EdgerEquals/plasma-ignition/sim/plots/03_fullchain_node_and_SRiso_delay.png

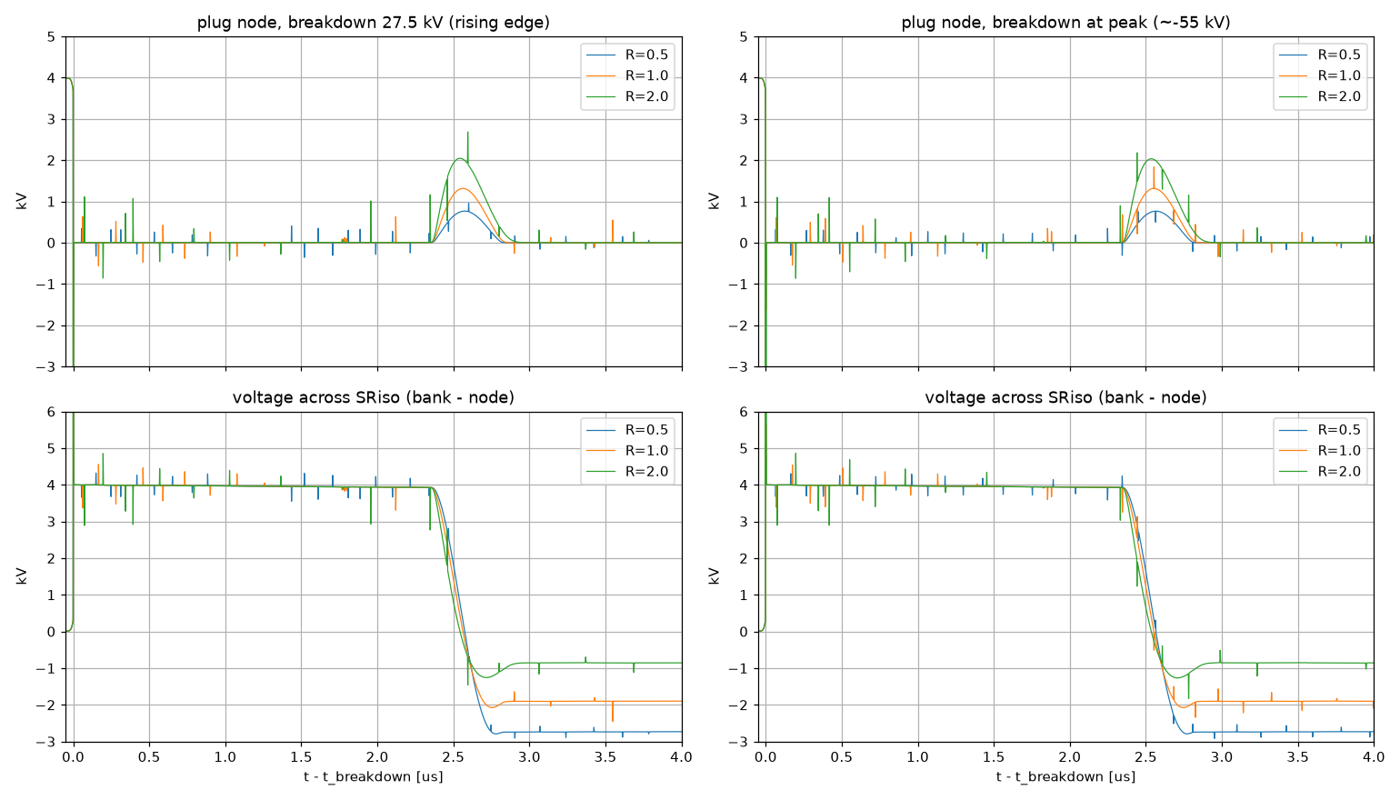
sim/plots/03_fullchain_node_and_SRiso_delay.png
