EdgerEquals/plasma-ignition/sim/plots/04_fullchain_stage2_current_bank.png

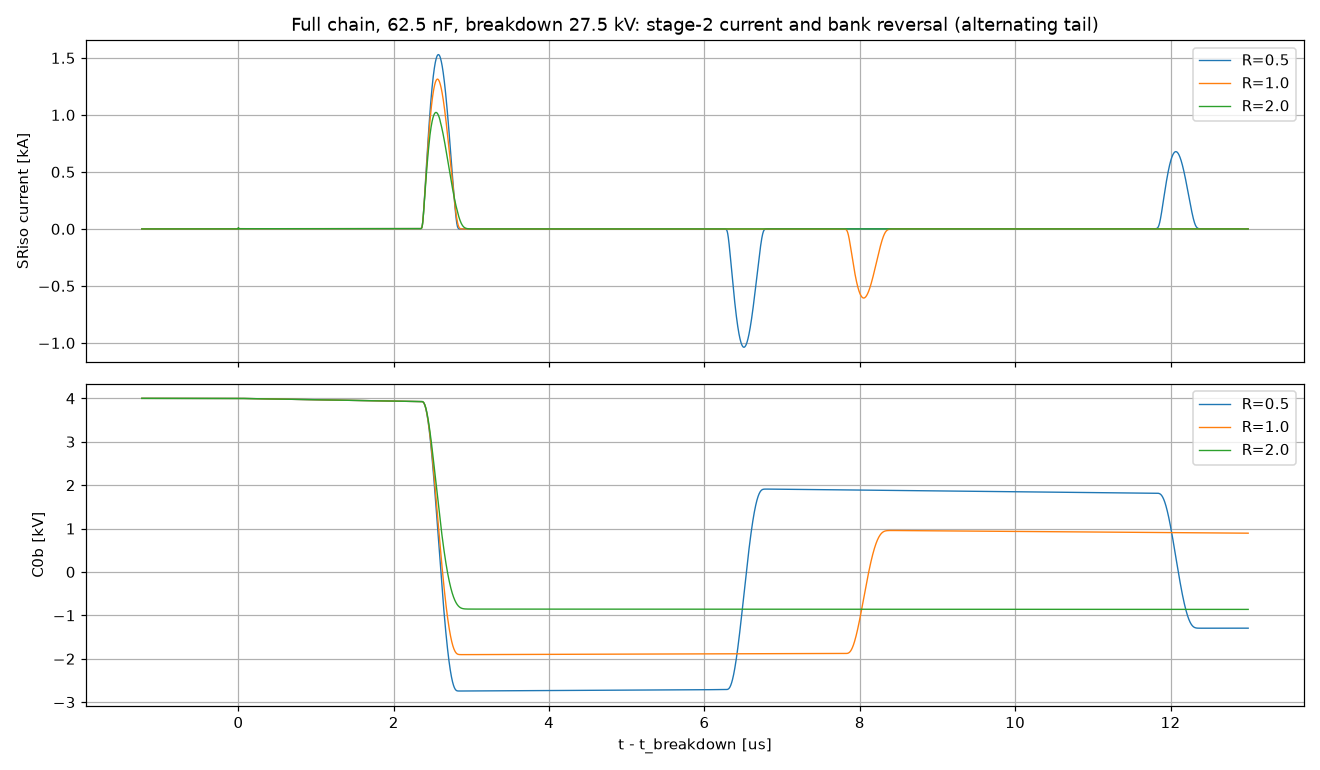
sim/plots/04_fullchain_stage2_current_bank.png
