EdgerEquals/plasma-ignition/sim/plots/05_quench_cases.png

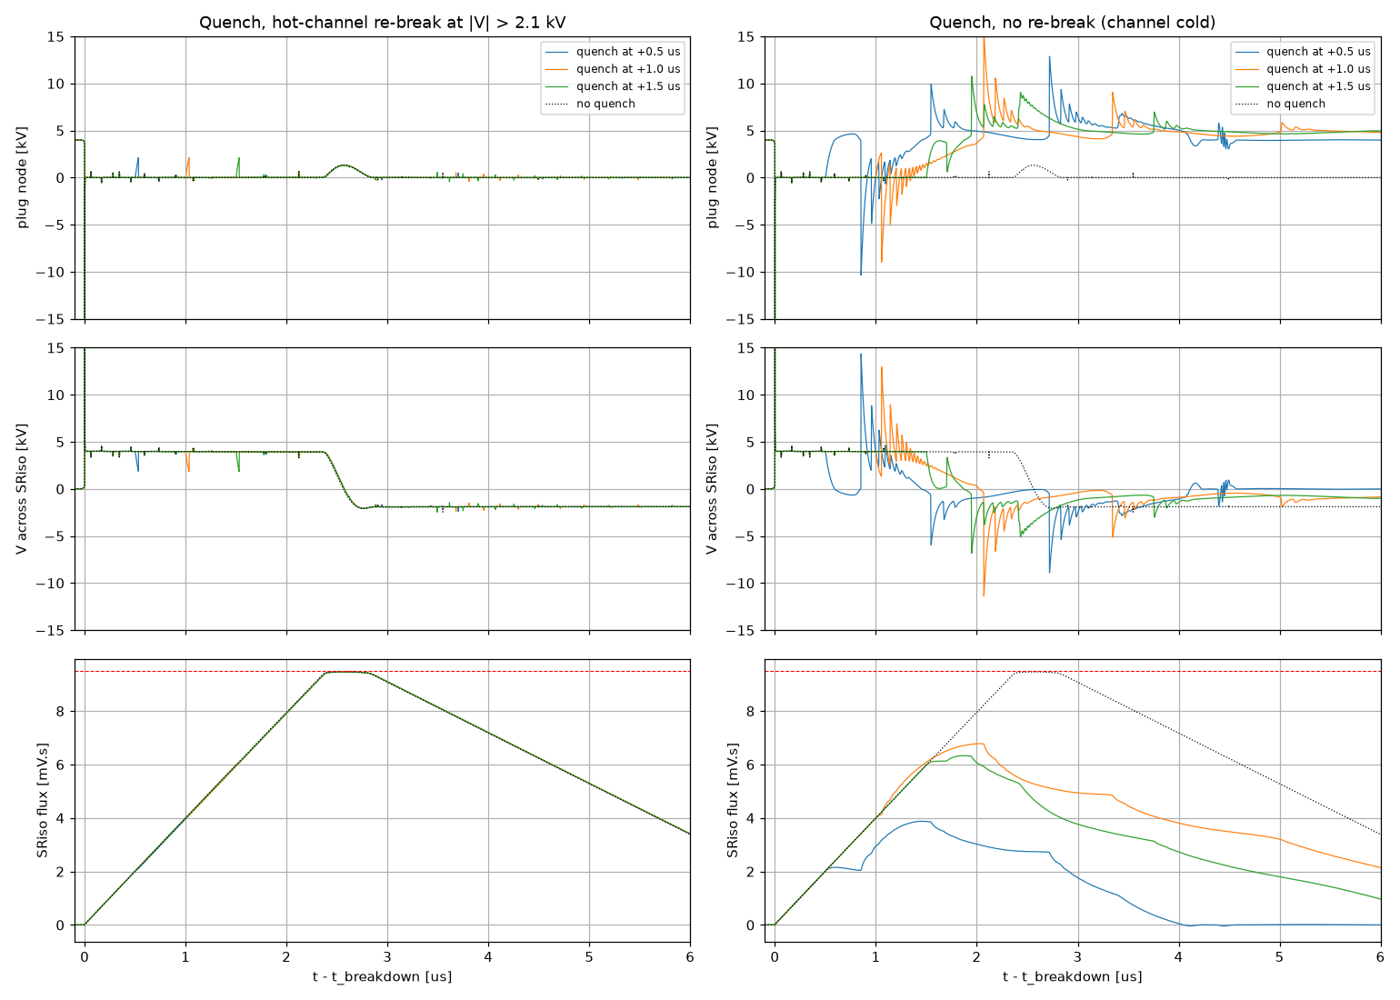
sim/plots/05_quench_cases.png
