EdgerEquals/plasma-ignition/sim/plots/06_core_model_comparison.png

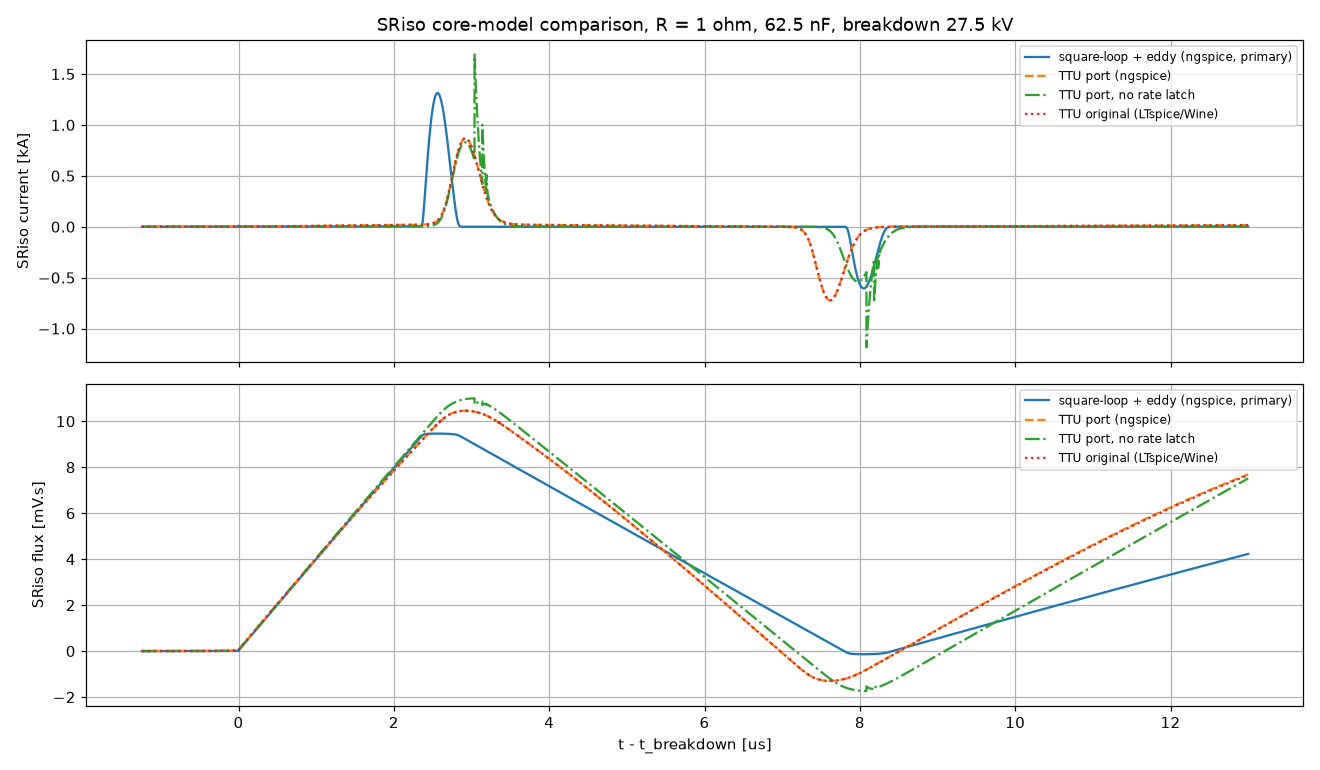
sim/plots/06_core_model_comparison.png
