EdgerEquals/plasma-ignition/sim/plots/07_summary_delivery_delay.png

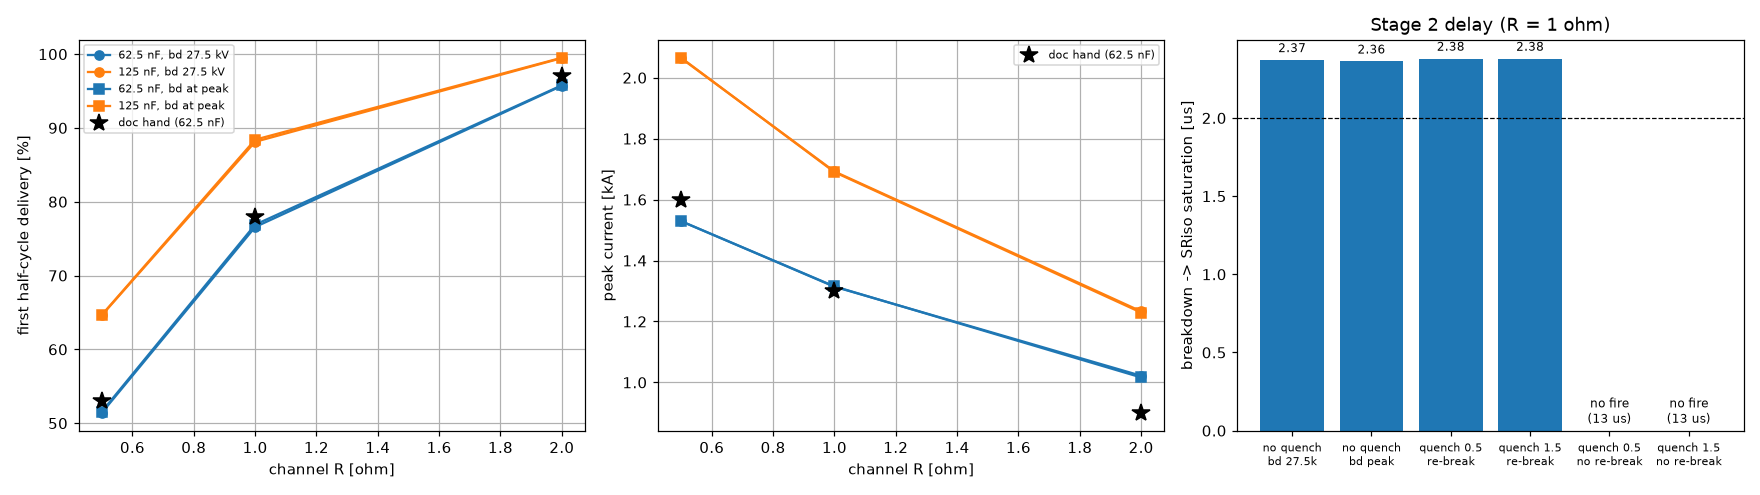
sim/plots/07_summary_delivery_delay.png
