EdgerEquals/plasma-ignition/sim/plots/08_jitter_and_flux_swing.png

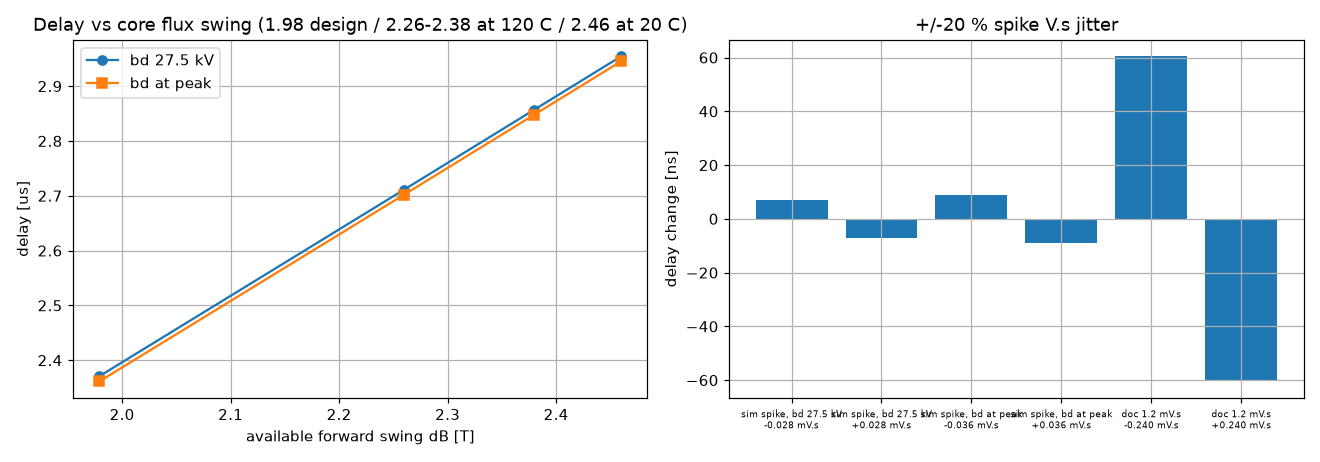
sim/plots/08_jitter_and_flux_swing.png
