EdgerEquals/plasma-ignition/sim/plots/09_quench_mitigations.png

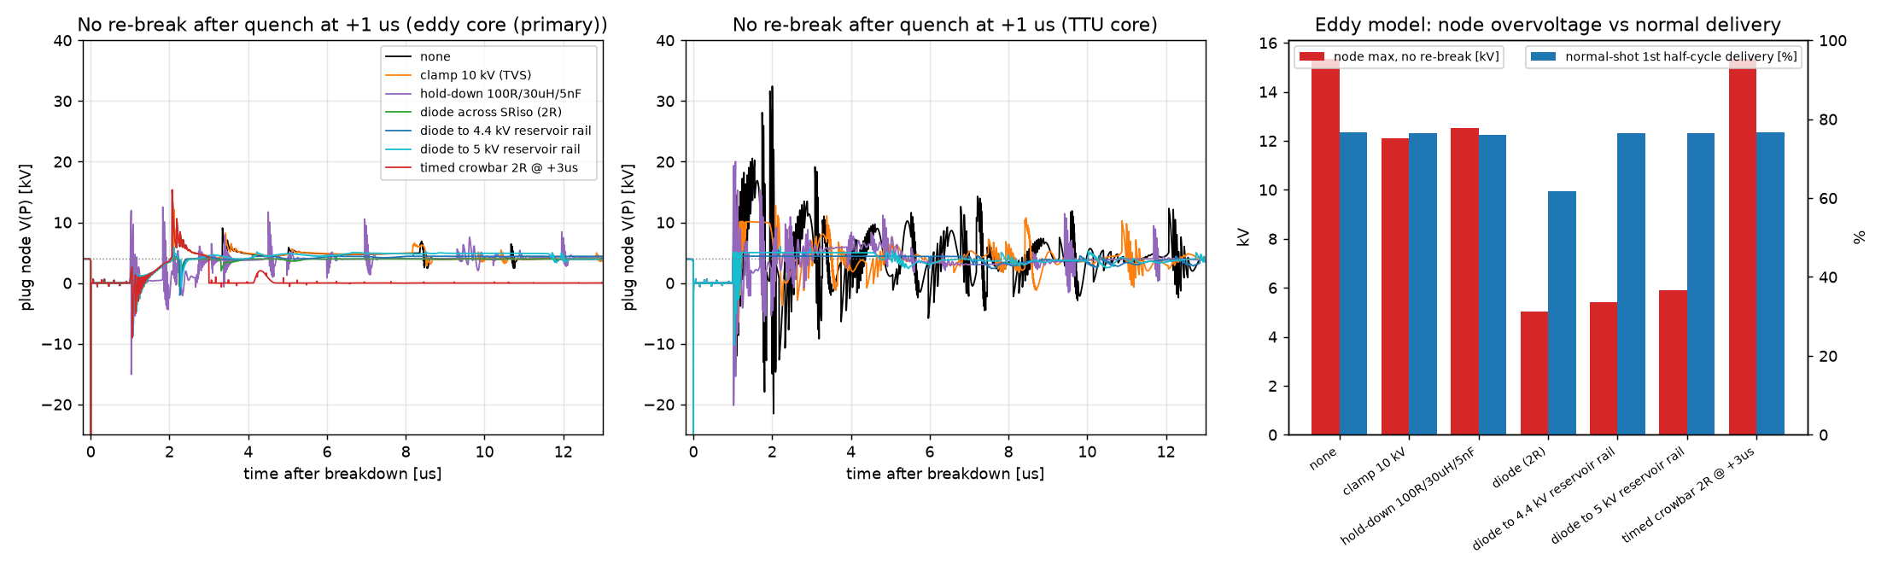
sim/plots/09_quench_mitigations.png
