EdgerEquals/plasma-ignition/sim/plots/10_sr3_ferrite.png

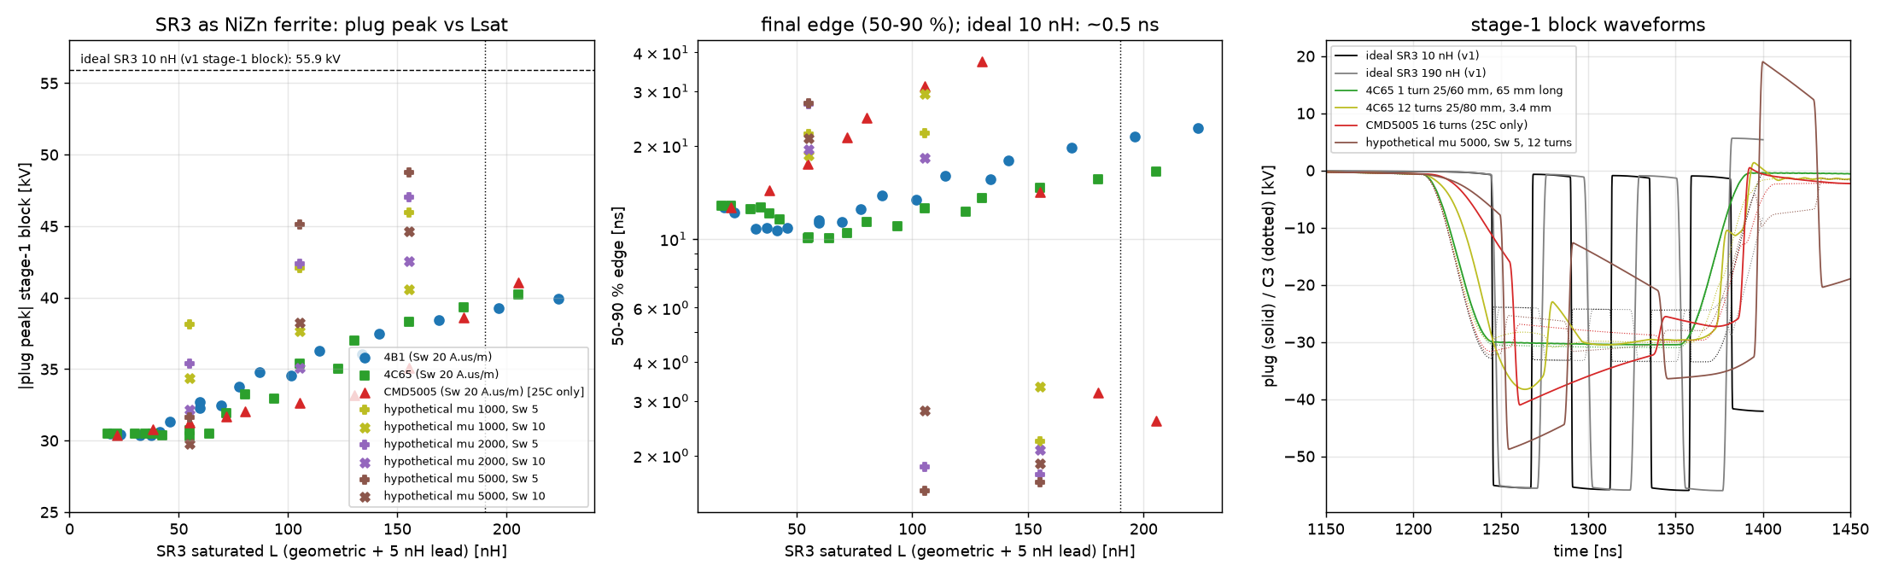
sim/plots/10_sr3_ferrite.png
