EdgerEquals/plasma-ignition/sim/plots/11_cblock_multishot.png

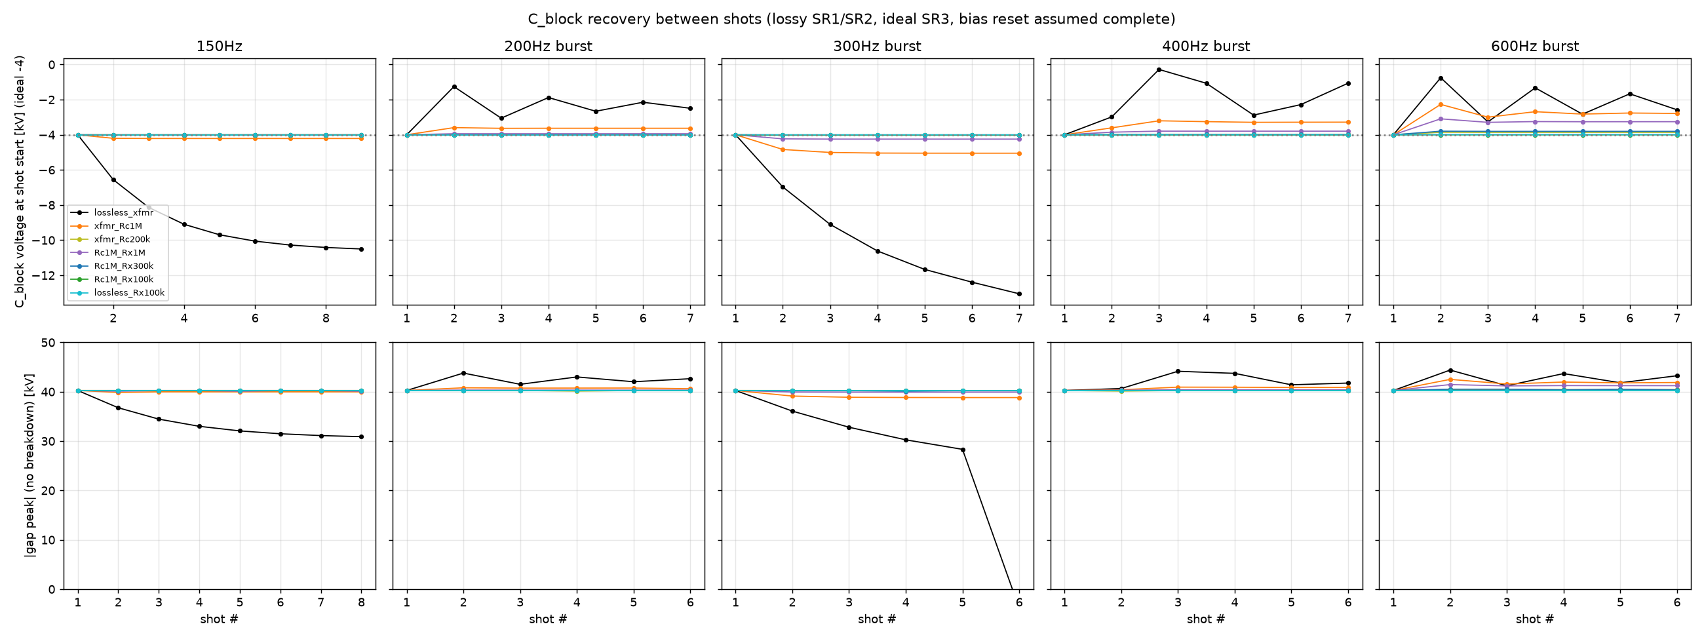
sim/plots/11_cblock_multishot.png
