EdgerEquals/plasma-ignition/sim/plots/12_cblock_recovery_waveforms.png

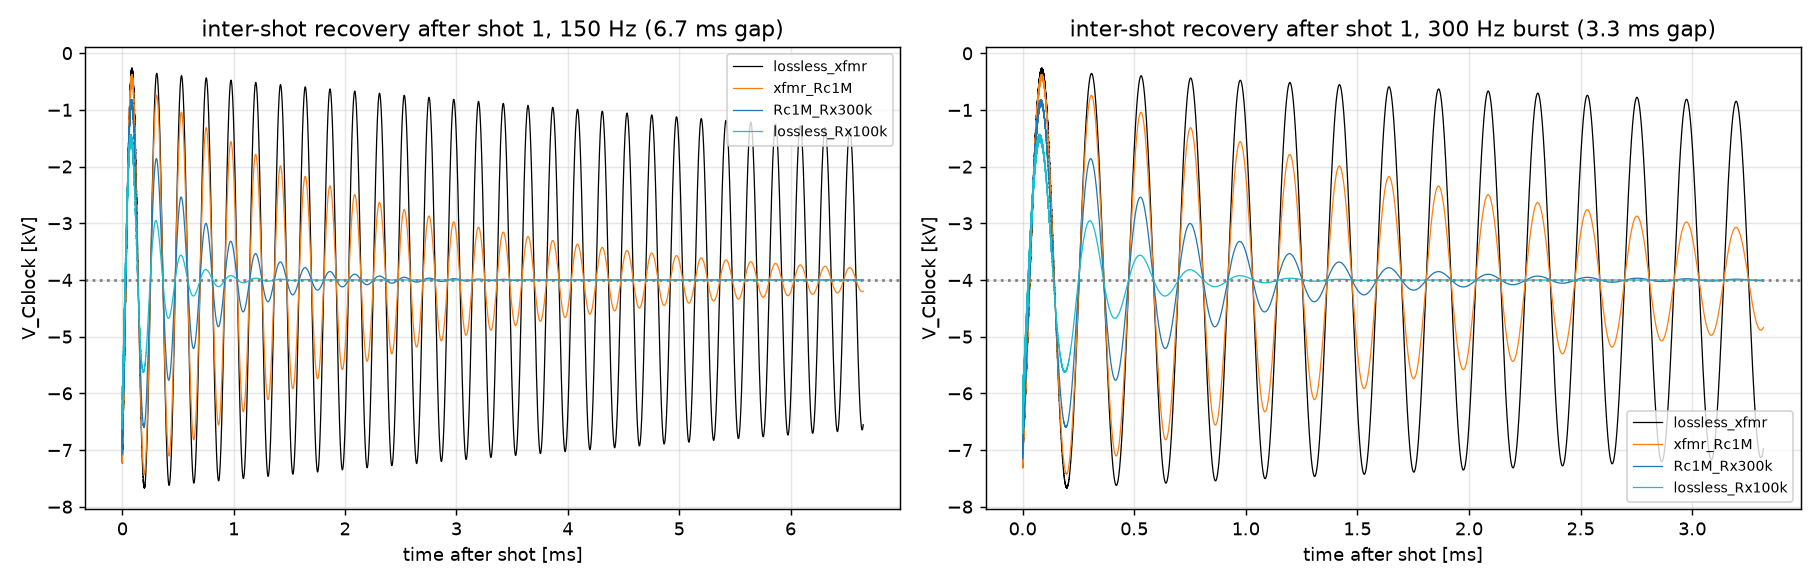
sim/plots/12_cblock_recovery_waveforms.png
