EdgerEquals/plasma-ignition/sim/plots/revc/revc_restrike_node.png

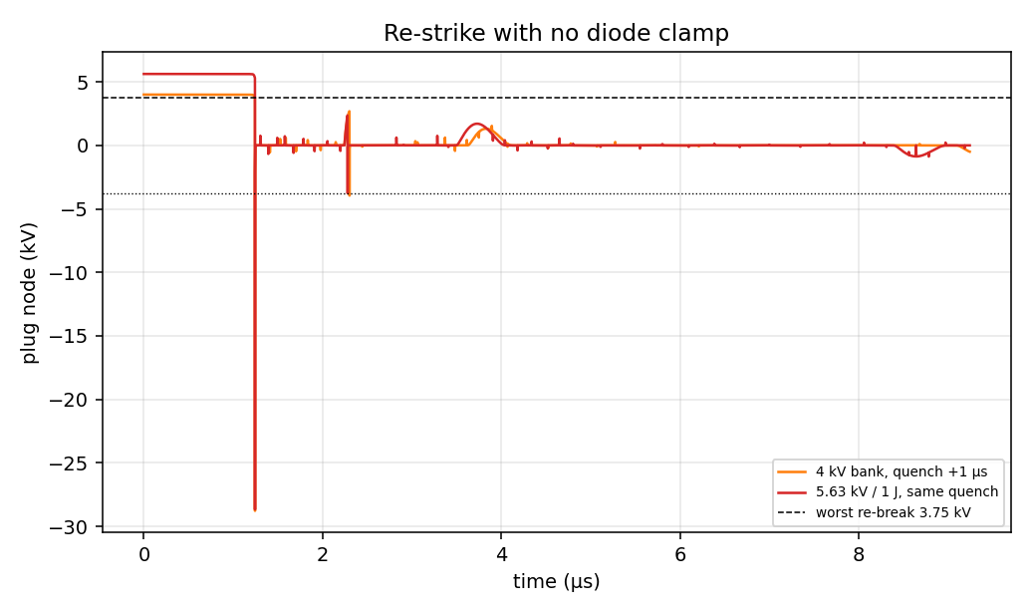
sim/plots/revc/revc_restrike_node.png
