EdgerEquals/plasma-ignition/sim/plots/revc/revc_sr3_edge.png

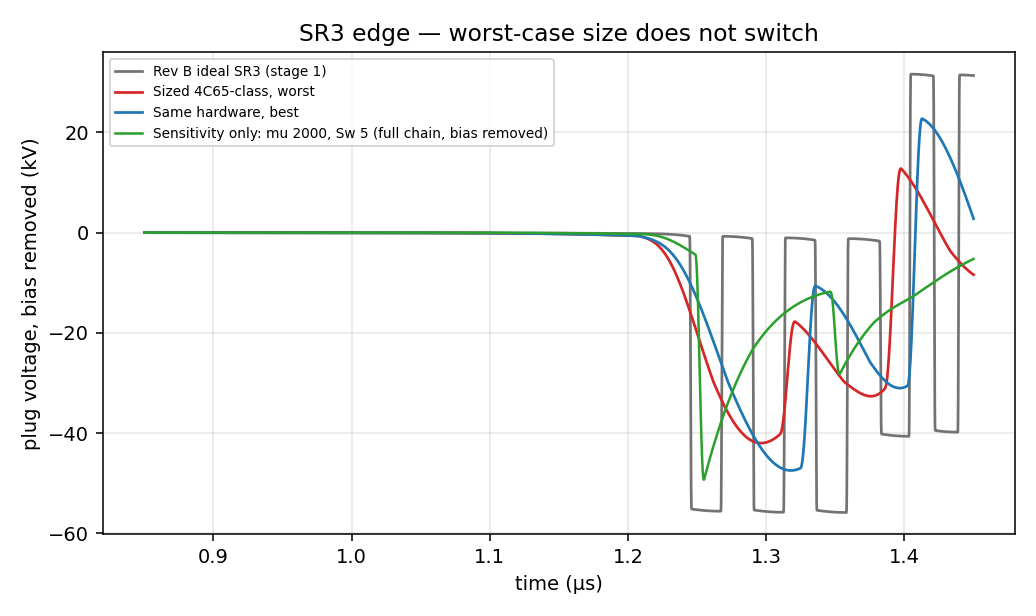
sim/plots/revc/revc_sr3_edge.png
