EdgerEquals/plasma-ignition/sim/plots/revc/revc_sriso_energy.png

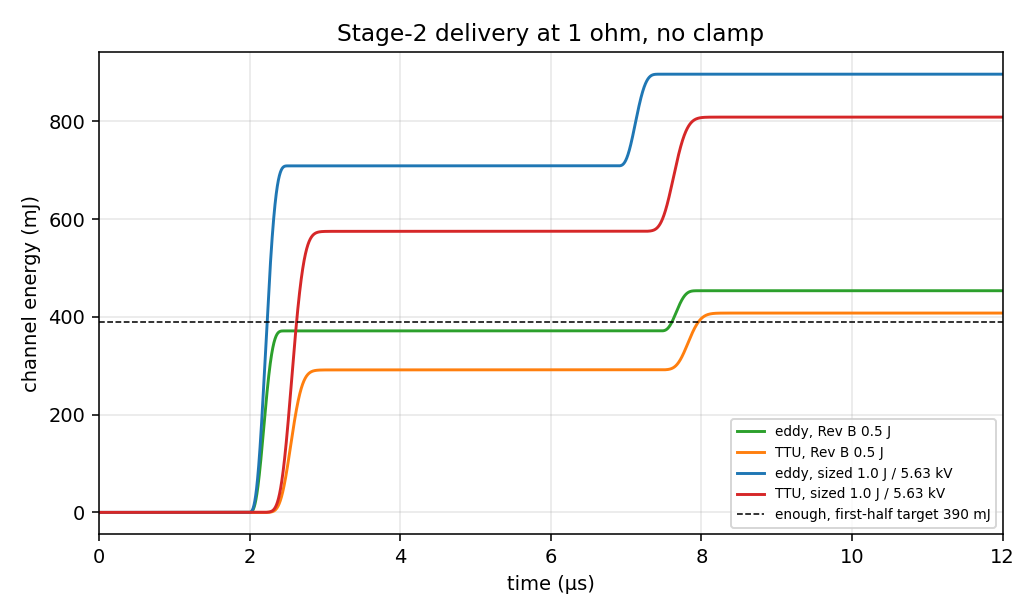
sim/plots/revc/revc_sriso_energy.png
