EdgerEquals/plasma-ignition/sim/results/tables.md

# Auto-generated tables (run_all.py)

## Block validation

| Block | Quantity | Hand (doc) | Sim | Unit | Error % | Note |
|---|---|---|---|---|---|---|
| Pulse transformer | C1 charge time (IGBT on -> C1 peak) | 1e+03 | 990 | ns | -0.99 |  |
| Pulse transformer | C1 peak voltage | 34.1 | 33.5 | kV | -1.8 | 1.1 kV x 31, lossless |
| SR1 | transfer time (saturation -> next cap peak) | 200 | 197 | ns | -1.3 | fires 16.9 ns after its cap peak, at 33.5 kV |
| SR1 | next-stage peak voltage | 34.1 | 32.9 | kV | -3.6 |  |
| SR2 | transfer time (saturation -> next cap peak) | 40 | 39.4 | ns | -1.4 | fires 0.7 ns after its cap peak, at 32.9 kV |
| SR2 | next-stage peak voltage | 34.1 | 32.9 | kV | -3.6 |  |
| SR3 (10 nH sat.) | C3 -> plug transfer to 98 % (10-90 % edge in note) | 2-5 | 1.12 | ns | - | 10-90 % edge 0.74 ns; ideal saturating L, ferrite switching time not modelled; fires 0.18 ns after C3 peak |
| SR3 + plug | ring-up V_plug/V_C3 | 1.74 | 1.69 | x | -2.7 | hand incl. 1 nF block + 1.5 pF Cw: 1.693x |
| SR3 + plug | plug swing (no bias, no breakdown) | 59 | 55.5 | kV | -5.9 | doc: 34 kV x 1.74 |
| SR3 (190 nH) | C3 -> plug transfer to 98 % | 5 | 4.76 | ns | -4.8 | 10-90 % edge 3.12 ns; plug 55.6 kV |
| SR3 sensitivity (L_unsat 5 uH) | plug peak | - | 45 | kV | - | 10-90 % edge 23.1 ns; SR3 never saturates: plug follows C3 through the unsaturated ferrite |
| SRiso | delay to saturation, spike 1.5 mV.s (doc accounting) | 2e+03 | 1.99e+03 | ns | -0.27 | hand = remaining V.s / 4 kV |
| SRiso | delay to saturation, no spike | 2.38e+03 | 2.38e+03 | ns | 0.045 | hand = remaining V.s / 4 kV |
| SRiso + C0b | Z0 = V0*exp(-a*pi/2w0)/Ipk (R=0.05 ohm) | 2.08 | 2.19 | ohm | 5.5 | includes core transition at saturation onset |
| SRiso + C0b | half-cycle | 408 | 456 | ns | 12 | sim measured from 50 A crossing to current zero |
| Stage 2 delivery | first half-cycle energy, R=0.5 ohm | 53 | 51.4 | % | -3.1 | exact RLC: 53.3 % |
| Stage 2 delivery | peak current, R=0.5 ohm | 1.6 | 1.53 | kA | -4.2 | exact RLC: 1.61 kA |
| Stage 2 delivery | first half-cycle energy, R=1.0 ohm | 78 | 76.7 | % | -1.6 | exact RLC: 78.9 % |
| Stage 2 delivery | peak current, R=1.0 ohm | 1.3 | 1.32 | kA | 1.3 | exact RLC: 1.38 kA |
| Stage 2 delivery | first half-cycle energy, R=2.0 ohm | 97 | 95.5 | % | -1.5 | exact RLC: 96.8 % |
| Stage 2 delivery | peak current, R=2.0 ohm | 0.9 | 1.02 | kA | 13 | exact RLC: 1.07 kA |

## Full-chain runs

| tag | ok | model | Vbd | R | C0b nF | quench +us | re-break | t_rebreak-t_q ns | spike V.s mV.s | delay us | node max in delay V | Viso min in delay V | 1st half % | Ipk kA | C0b reversal % | E_ch total mJ | E_ch stage-1 mJ | spike->branch peak mJ (% of 58) | Cw peak mJ | core eddy spike mJ | lam end mV.s |
|---|---|---|---|---|---|---|---|---|---|---|---|---|---|---|---|---|---|---|---|---|---|
| base_bd27k5_C625_R0.5 | True | eddy | 2.75e+04 | 0.5 | 62.5 | - | - | - | 0.138 | 2.371 | 406 | 3.55e+03 | 51.4 | 1.53 | 68.6 | 435 | 20.7 | 0.64 (1.1 %) | 0.765 | 0.32 | 8.52 |
| base_bd27k5_C625_R1.0 | True | eddy | 2.75e+04 | 1 | 62.5 | - | - | - | 0.142 | 2.371 | 633 | 3.31e+03 | 76.6 | 1.31 | 47.6 | 476 | 24.3 | 0.68 (1.2 %) | 0.804 | 0.354 | 4.23 |
| base_bd27k5_C625_R2.0 | True | eddy | 2.75e+04 | 2 | 62.5 | - | - | - | 0.148 | 2.371 | 1.11e+03 | 2.89e+03 | 95.7 | 1.02 | 21.6 | 493 | 31.9 | 0.75 (1.3 %) | 0.872 | 0.408 | 0.703 |
| base_bd27k5_C1250_R0.5 | True | eddy | 2.75e+04 | 0.5 | 125 | - | - | - | 0.138 | 2.36 | 406 | 3.57e+03 | 64.6 | 2.06 | 59 | 874 | 20.7 | 0.64 (1.1 %) | 0.763 | 0.32 | 7.36 |
| base_bd27k5_C1250_R1.0 | True | eddy | 2.75e+04 | 1 | 125 | - | - | - | 0.142 | 2.36 | 634 | 3.34e+03 | 88.1 | 1.69 | 34.2 | 990 | 24.2 | 0.67 (1.2 %) | 0.802 | 0.353 | 1.1 |
| base_bd27k5_C1250_R2.0 | True | eddy | 2.75e+04 | 2 | 125 | - | - | - | 0.148 | 2.361 | 1.11e+03 | 2.89e+03 | 99.5 | 1.23 | 9.09 | 1.01e+03 | 31.9 | 0.74 (1.3 %) | 0.87 | 0.408 | 5.91 |
| base_bdpeak_C625_R0.5 | True | eddy | peak | 0.5 | 62.5 | - | - | - | 0.174 | 2.362 | 348 | 3.58e+03 | 51.6 | 1.53 | 68.6 | 444 | 28.2 | 2.51 (4.3 %) | 2.27 | 0.95 | 8.51 |
| base_bdpeak_C625_R1.0 | True | eddy | peak | 1 | 62.5 | - | - | - | 0.178 | 2.362 | 609 | 3.39e+03 | 76.9 | 1.32 | 47.6 | 483 | 30.1 | 2.51 (4.3 %) | 2.27 | 0.998 | 4.24 |
| base_bdpeak_C625_R2.0 | True | eddy | peak | 2 | 62.5 | - | - | - | 0.184 | 2.362 | 1.1e+03 | 2.89e+03 | 95.8 | 1.02 | 21.6 | 496 | 33.5 | 2.51 (4.3 %) | 2.27 | 1.07 | 0.699 |
| base_bdpeak_C1250_R0.5 | True | eddy | peak | 0.5 | 125 | - | - | - | 0.174 | 2.351 | 347 | 3.62e+03 | 64.7 | 2.07 | 59 | 883 | 27.6 | 2.51 (4.3 %) | 2.27 | 0.947 | 7.37 |
| base_bdpeak_C1250_R1.0 | True | eddy | peak | 1 | 125 | - | - | - | 0.178 | 2.351 | 608 | 3.39e+03 | 88.4 | 1.69 | 34.1 | 996 | 29.8 | 2.51 (4.3 %) | 2.27 | 0.996 | 1.09 |
| base_bdpeak_C1250_R2.0 | True | eddy | peak | 2 | 125 | - | - | - | 0.184 | 2.351 | 1.1e+03 | 2.9e+03 | 99.5 | 1.23 | 9.11 | 1.01e+03 | 33.3 | 2.51 (4.3 %) | 2.27 | 1.07 | 5.9 |
| quench_bd27k5_R0.5_tq0.5_rb | True | eddy | 2.75e+04 | 0.5 | 62.5 | 0.5 | True | 25.8 | 0.138 | 2.378 | 2.1e+03 | 1.88e+03 | 51.2 | 1.53 | 68.6 | 434 | 19.5 | 0.64 (1.1 %) | 0.765 | 0.32 | 8.52 |
| quench_bd27k5_R0.5_tq0.5_norb | True | eddy | 2.75e+04 | 0.5 | 62.5 | 0.5 | False | - | 0.138 | - | 1.33e+04 | -9.33e+03 | - | - | - | 16.8 | 16.8 | 0.64 (1.1 %) | 0.765 | 0.32 | -0.0118 |
| quench_bd27k5_R0.5_tq1.0_rb | True | eddy | 2.75e+04 | 0.5 | 62.5 | 1 | True | 29.7 | 0.138 | 2.38 | 2.1e+03 | 1.87e+03 | 51.4 | 1.53 | 68.6 | 435 | 20.7 | 0.64 (1.1 %) | 0.765 | 0.32 | 8.53 |
| quench_bd27k5_R0.5_tq1.0_norb | True | eddy | 2.75e+04 | 0.5 | 62.5 | 1 | False | - | 0.138 | - | 1.37e+04 | -9.74e+03 | - | - | - | 17.6 | 17.6 | 0.64 (1.1 %) | 0.765 | 0.32 | 0.00527 |
| quench_bd27k5_R0.5_tq1.5_rb | True | eddy | 2.75e+04 | 0.5 | 62.5 | 1.5 | True | 17.6 | 0.138 | 2.373 | 1.03e+03 | 2.93e+03 | 51.4 | 1.53 | 68.6 | 435 | 20.8 | 0.64 (1.1 %) | 0.765 | 0.32 | 8.53 |
| quench_bd27k5_R0.5_tq1.5_norb | True | eddy | 2.75e+04 | 0.5 | 62.5 | 1.5 | False | - | 0.138 | - | 1.14e+04 | -7.51e+03 | - | - | - | 18.1 | 18.1 | 0.64 (1.1 %) | 0.765 | 0.32 | 0.00239 |
| quench_bd27k5_R1.0_tq0.5_rb | True | eddy | 2.75e+04 | 1 | 62.5 | 0.5 | True | 32.2 | 0.142 | 2.38 | 2.1e+03 | 1.88e+03 | 76.7 | 1.31 | 47.6 | 476 | 24.5 | 0.68 (1.2 %) | 0.804 | 0.354 | 4.25 |
| quench_bd27k5_R1.0_tq0.5_norb | True | eddy | 2.75e+04 | 1 | 62.5 | 0.5 | False | - | 0.142 | - | 1.29e+04 | -8.91e+03 | - | - | - | 22.7 | 22.7 | 0.68 (1.2 %) | 0.804 | 0.354 | 0.000271 |
| quench_bd27k5_R1.0_tq1.0_rb | True | eddy | 2.75e+04 | 1 | 62.5 | 1 | True | 34.6 | 0.142 | 2.381 | 2.1e+03 | 1.87e+03 | 76.6 | 1.31 | 47.6 | 477 | 24.3 | 0.68 (1.2 %) | 0.804 | 0.354 | 4.21 |
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
| cmp_ttu_nolatch_bdpeak_R0.5 | True | TTU port (ngspice), no rate latch | peak | 0.5 | 62.5 | - | - | - | 0.214 | 2.568 | 366 | 3.58e+03 | 40.1 | 1.84 | 85.3 | 452 | 28.4 | 2.21 (3.8 %) | 2.29 | 0.345 | 8.85 |
| cmp_ttu_nolatch_bd27k5_R1.0 | True | TTU port (ngspice), no rate latch | 2.75e+04 | 1 | 62.5 | - | - | - | 0.172 | 2.58 | 634 | 3.37e+03 | 63.5 | 1.69 | 68.8 | 469 | 24.3 | 0.65 (1.1 %) | 0.804 | 0.0925 | 7.51 |
| cmp_ttu_nolatch_bdpeak_R1.0 | True | TTU port (ngspice), no rate latch | peak | 1 | 62.5 | - | - | - | 0.218 | 2.569 | 673 | 3.27e+03 | 63.4 | 1.69 | 68.9 | 474 | 30.2 | 2.21 (3.8 %) | 2.29 | 0.359 | 7.54 |
| cmp_ttu_nolatch_bd27k5_R2.0 | True | TTU port (ngspice), no rate latch | 2.75e+04 | 2 | 62.5 | - | - | - | 0.179 | 2.581 | 1.11e+03 | 2.87e+03 | 86.7 | 1.47 | 45.9 | 521 | 31.9 | 0.71 (1.2 %) | 0.866 | 0.109 | 0.858 |
| cmp_ttu_nolatch_bdpeak_R2.0 | True | TTU port (ngspice), no rate latch | peak | 2 | 62.5 | - | - | - | 0.224 | 2.57 | 1.11e+03 | 2.89e+03 | 86.6 | 1.47 | 45.9 | 524 | 34.7 | 2.21 (3.8 %) | 2.29 | 0.38 | 0.878 |
| cmp_ttu_nolatch_quench1.0_rb | True | TTU port (ngspice), no rate latch | 2.75e+04 | 1 | 62.5 | 1 | True | 58.2 | 0.172 | 2.595 | 1.64e+03 | 2.35e+03 | 63.3 | 1.69 | 68.8 | 469 | 24.6 | 0.65 (1.1 %) | 0.804 | 0.0925 | 7.49 |
| cmp_ttu_nolatch_quench1.0_norb | True | TTU port (ngspice), no rate latch | 2.75e+04 | 1 | 62.5 | 1 | False | - | 0.172 | - | 3.02e+04 | -2.62e+04 | - | - | - | 23.4 | 23.4 | 0.65 (1.1 %) | 0.804 | 0.0925 | 4.16 |
| cmp_ttu_lt_bd27k5_R0.5 | True | TTU original (LTspice/Wine) | 2.75e+04 | 0.5 | 62.5 | - | - | - | 0.168 | 2.541 | 411 | 3.42e+03 | 36.6 | 0.998 | 84.2 | 335 | 20.9 | 0.61 (1.1 %) | 0.777 | 0.11 | 9.51 |
| cmp_ttu_lt_bdpeak_R0.5 | True | TTU original (LTspice/Wine) | peak | 0.5 | 62.5 | - | - | - | 0.202 | 2.541 | 398 | 3.07e+03 | 34.3 | 1.04 | 87.7 | 311 | 28.6 | 2.14 (3.7 %) | 2.28 | 0.345 | 9.6 |
| cmp_ttu_lt_bd27k5_R1.0 | True | TTU original (LTspice/Wine) | 2.75e+04 | 1 | 62.5 | - | - | - | 0.172 | 2.545 | 634 | 3.13e+03 | 58.1 | 0.869 | 73.6 | 412 | 24.7 | 0.64 (1.1 %) | 0.81 | 0.122 | 7.65 |
| cmp_ttu_lt_bdpeak_R1.0 | True | TTU original (LTspice/Wine) | peak | 1 | 62.5 | - | - | - | 0.206 | 2.547 | 705 | 2.71e+03 | 54.7 | 0.796 | 79.3 | 404 | 31.2 | 2.14 (3.7 %) | 2.28 | 0.362 | 7.73 |
| cmp_ttu_lt_bd27k5_R2.0 | True | TTU original (LTspice/Wine) | 2.75e+04 | 2 | 62.5 | - | - | - | 0.178 | 2.553 | 1.12e+03 | 2.51e+03 | 80.3 | 0.689 | 60.9 | 489 | 32.8 | 0.70 (1.2 %) | 0.87 | 0.142 | 3.4 |
| cmp_ttu_lt_bdpeak_R2.0 | True | TTU original (LTspice/Wine) | peak | 2 | 62.5 | - | - | - | 0.212 | 2.559 | 1.11e+03 | 2.32e+03 | 77.2 | 0.606 | 69 | 485 | 36.6 | 2.14 (3.7 %) | 2.28 | 0.387 | 4.04 |
| cmp_ttu_lt_quench1.0_rb | True | TTU original (LTspice/Wine) | 2.75e+04 | 1 | 62.5 | 1 | True | 5.38 | 0.172 | 2.546 | 2.1e+03 | 1.83e+03 | 58.1 | 0.869 | 73.6 | 412 | 24.7 | 0.64 (1.1 %) | 0.81 | 0.122 | 7.65 |
| cmp_ttu_lt_quench1.0_norb | True | TTU original (LTspice/Wine) | 2.75e+04 | 1 | 62.5 | 1 | False | - | 0.172 | - | 3.38e+04 | -2.98e+04 | - | - | - | 23.4 | 23.4 | 0.64 (1.1 %) | 0.81 | 0.122 | 0.137 |
| jit_simspike_-20 | True | eddy | 2.75e+04 | 1 | 62.5 | - | - | - | 0.142 | 2.378 | 633 | 3.31e+03 | 76.6 | 1.31 | 47.6 | 476 | 24.3 | 0.68 (1.2 %) | 0.804 | 0.354 | 4.21 |
| jit_simspike_+20 | True | eddy | 2.75e+04 | 1 | 62.5 | - | - | - | 0.142 | 2.364 | 633 | 3.31e+03 | 76.6 | 1.31 | 47.6 | 476 | 24.3 | 0.68 (1.2 %) | 0.804 | 0.354 | 4.25 |
| jit_simspike_pk_-20 | True | eddy | peak | 1 | 62.5 | - | - | - | 0.178 | 2.371 | 609 | 3.39e+03 | 76.9 | 1.31 | 47.6 | 483 | 30 | 2.51 (4.3 %) | 2.27 | 0.998 | 4.22 |
| jit_simspike_pk_+20 | True | eddy | peak | 1 | 62.5 | - | - | - | 0.178 | 2.353 | 608 | 3.39e+03 | 76.9 | 1.32 | 47.6 | 484 | 30.1 | 2.51 (4.3 %) | 2.27 | 0.998 | 4.26 |
| jit_doc1.2mV.s_-20 | True | eddy | 2.75e+04 | 1 | 62.5 | - | - | - | 0.142 | 2.432 | 633 | 3.31e+03 | 76.6 | 1.31 | 47.7 | 477 | 24.3 | 0.68 (1.2 %) | 0.804 | 0.354 | 4.08 |
| jit_doc1.2mV.s_+20 | True | eddy | 2.75e+04 | 1 | 62.5 | - | - | - | 0.142 | 2.311 | 633 | 3.31e+03 | 76.6 | 1.32 | 47.6 | 478 | 24.3 | 0.68 (1.2 %) | 0.804 | 0.353 | 4.39 |
| sens_SR1SR2_LuLs_300 | True | eddy | 2.75e+04 | 1 | 62.5 | - | - | - | 0.152 | 2.369 | 765 | 3.18e+03 | 76.5 | 1.31 | 47.6 | 471 | 17.4 | 0.65 (1.1 %) | 0.778 | 0.358 | 4.25 |
