EdgerEquals/plasma-ignition/sim/results/v2_tables.md

# v2 result tables (generated by run_v2.py)

## Item 1 - no-re-break quench mitigations (eddy core; quench at +1 us)

| mitigation | gap peak, no bd [kV] | normal: 1st half-cycle delivery [%] | normal: channel energy / bank [%] | normal: energy into mitigation [mJ] | no re-break: node max [kV] | no re-break: node min [kV] | no re-break: stage 2 fires | no re-break: bank energy kept [mJ] | no re-break: energy into mitigation [mJ] | re-break only >12 kV: fires / delay [us] | TTU no re-break node max [kV] |
|---|---|---|---|---|---|---|---|---|---|---|---|
| none | -51.1 | 76.6 | 91.1 | 0.0 | 15.3 | -9.0 | no | 489 | 0.0 | yes / 2.74 | 32.4 |
| holddown_R100_L1e-05_C2e-09 | -51.0 | 76.0 | 90.9 | 2.2 | 14.9 | -7.2 | no | 453 | 33.1 | yes / 2.38 | - |
| holddown_R100_L3e-05_C2e-09 | -51.1 | 76.1 | 91.1 | 1.5 | 16.4 | -7.6 | yes | 446 | 36.4 | yes / 2.24 | - |
| holddown_R100_L0.0001_C2e-09 | -50.9 | 76.0 | 91.0 | 1.5 | 19.0 | -15.1 | yes | 452 | 22.8 | yes / 2.42 | - |
| holddown_R100_L1e-05_C5e-09 | -51.0 | 75.8 | 90.8 | 2.5 | 13.9 | -6.3 | yes | 418 | 67.5 | yes / 2.49 | - |
| holddown_R100_L3e-05_C5e-09 | -51.1 | 76.0 | 91.0 | 1.6 | 12.5 | -15.0 | no | 414 | 68.7 | yes / 2.43 | 20.0 |
| holddown_R100_L0.0001_C5e-09 | -51.1 | 76.1 | 91.2 | 1.0 | 19.1 | -19.7 | no | 431 | 42.2 | yes / 2.40 | - |
| holddown_R100_L1e-05_C1e-08 | -50.9 | 76.0 | 91.1 | 1.3 | 12.8 | -13.8 | no | 402 | 84.9 | yes / 2.44 | - |
| holddown_R100_L3e-05_C1e-08 | -51.1 | 76.3 | 91.3 | 0.1 | 20.6 | -20.7 | no | 407 | 76.2 | yes / 2.40 | - |
| holddown_R100_L0.0001_C1e-08 | -51.1 | 77.4 | 92.2 | -3.6 | 22.0 | -21.3 | no | 438 | 35.2 | yes / 2.40 | - |
| holddown_R30_L3e-05_C5e-09 | -51.1 | 76.4 | 91.2 | -0.2 | 19.5 | -18.0 | yes | 401 | 61.3 | yes / 2.40 | - |
| holddown_R300_L3e-05_C5e-09 | -51.1 | 76.5 | 91.3 | 0.0 | 13.1 | -12.9 | no | 452 | 37.3 | yes / 2.42 | - |
| clamp_X6000 | -50.1 | 76.5 | 91.4 | -0.0 | 9.7 | -8.8 | no | 487 | 4.4 | no | - |
| clamp_X10000 | -50.1 | 76.5 | 91.4 | -0.0 | 12.1 | -8.8 | no | 489 | 1.5 | yes / 2.77 | 12.7 |
| holddown+clamp_R100_L3e-05_C5e-09_X10000 | -50.1 | 76.1 | 90.7 | 1.6 | 11.0 | -13.3 | no | 413 | 70.8 | yes / 2.44 | - |
| holddown_R1000_L1e-06_C5e-09 | -50.6 | 76.7 | 91.3 | -0.2 | 13.0 | -9.2 | no | 474 | 20.4 | yes / 3.18 | - |
| diode_Ron2_Cd2e-12 | -50.1 | 61.9 | 60.3 | 186.7 | 5.0 | -8.8 | no | 489 | 1.5 | no | - |
| diode_Ron2_Cd5e-12 | -48.7 | 61.9 | 60.3 | 186.8 | 5.0 | -8.5 | no | 489 | 1.6 | no | - |
| crowbar_t_fire3e-06_Rd2 (normal = no mitigation, timed) | -51.1 | 76.6 | 91.1 | 0.0 | 15.3 | -9.0 | yes | 23 | 460.0 | yes / 2.74 | - |
| kick_t_fire2e-06_I15_w3e-07 (normal = no mitigation, timed) | -51.1 | 76.6 | 91.1 | 0.0 | 38.1 | -33.1 | yes | 490 | 0.0 | yes / 2.64 | - |
| diode_Ron30_Cd2e-12 | -50.1 | 74.4 | 73.7 | 121.2 | 10.2 | -8.8 | no | 489 | 2.5 | no | - |
| diode_Ron100_Cd2e-12 | -50.1 | 75.9 | 74.5 | 110.9 | 12.7 | -8.8 | no | 490 | 2.5 | yes / 2.77 | - |
| diode_Ron300_Cd2e-12 | -50.1 | 76.3 | 83.3 | 54.3 | 14.1 | -8.8 | no | 490 | 2.6 | yes / 2.77 | 15.4 |
| diode_Ron1000_Cd2e-12 | -50.1 | 76.5 | 88.6 | 18.2 | 14.8 | -8.8 | no | 489 | 2.7 | yes / 2.77 | 12.7 |
| rclamp_X4400_Ron2 | -50.1 | 76.5 | 91.4 | -0.0 | 5.4 | -8.8 | no | 476 | 15.2 | no | 5.4 |
| rclamp_X5000_Ron2 | -50.1 | 76.5 | 91.4 | -0.0 | 5.9 | -8.8 | no | 483 | 8.2 | no | 6.0 |
| rclamp_X6000_Ron2 | -50.1 | 76.5 | 91.4 | -0.0 | 6.7 | -8.8 | no | 486 | 5.6 | no | - |
| rclamp_X4400_Ron10 | -50.1 | 76.5 | 91.4 | -0.0 | 7.7 | -8.8 | no | 478 | 14.8 | no | - |

## Item 2 - SR3 as NiZn ferrite (stage-1 block: plug starts at 0, no bias, no breakdown)

Hold-off fixed at fvs x 0.68 mV.s; A = fvs*0.68e-3/(N*dB_hot); length = A/((OD-ID)/2); Lsat = N^2*2e-7*len*ln(b/a) + 5 nH lead, a = ID/2-2 mm, b = OD/2+8 mm.

| material | N | ID/OD [mm] | fvs | Sw [A.us/m] | stack length [mm] | Lsat [nH] | L_static [uH] | R_visc [ohm] | bias [A-turns] | saturates | plug peak [kV] | 10-90 % [ns] | 50-90 % [ns] | plug V when SR3 saturates [kV] |
|---|---|---|---|---|---|---|---|---|---|---|---|---|---|---|
| 4B1 | 1 | 25/60 | 1 | 20 | 70.6 | 23 | 2.9 | 255 | 170 | no | -30.5 | 25.7 | 12.2 | - |
| 4B1 | 1 | 25/60 | 1.5 | 20 | 106.0 | 32 | 4.4 | 382 | 170 | no | -30.4 | 25.8 | 12.0 | - |
| 4B1 | 1 | 25/80 | 1 | 20 | 45.0 | 19 | 2.4 | 206 | 210 | no | -30.5 | 25.7 | 12.6 | - |
| 4B1 | 1 | 25/80 | 1.5 | 20 | 67.4 | 25 | 3.5 | 309 | 210 | no | -30.5 | 25.7 | 12.5 | - |
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
| lossless_Rx100k | 300Hz_burst | -4.00 -4.00 -4.00 -4.00 -4.00 -4.00 -> -4.00 | -40.2 | 4.78 |
| lossless_Rx100k | 400Hz_burst | -4.00 -4.00 -4.00 -4.00 -4.00 -4.00 -> -4.00 | -40.2 | 4.78 |
| lossless_Rx100k | 600Hz_burst | -4.00 -3.99 -3.99 -3.99 -3.99 -3.99 -> -3.99 | -40.2 | 4.77 |
