EdgerEquals/plasma-ignition/sim/results/results.csv

C0b | Cw | E_Cw_peak | E_bank0 | E_bank_end | E_branch_spike_net | E_branch_spike_peak | E_ch_first_half | E_ch_stage1 | E_ch_stage2_total | E_ch_total | E_core_spike | Ich_after_rebreak_max | Ich_after_rebreak_median | Iiso_delay_max | Ipk | Ipk_first | L3s | L3u | Rch | VSiso | Vbank_at_sat | Vbank_rev_min | Vbd | Viso_delay_min | Viso_max_spike | Vnode_delay_max | Vnode_min | Vnode_peak_nobd | bd_mode | dB | dB_label | dVbank_spike | delay | err | frac_first_half | jit_dVs | jit_ref | ke | lam_at_bd | lam_end | lam_max | lam_spike | model | model_label | ok | rebreak | reversal | runtime_s | sens | simulator | t_bd | t_half | t_peak_nobd | t_rebreak | t_sat | t_second_sat | t_spike_start | tag | tq
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
