EdgerEquals/plasma-ignition/sim/plots/01_stage1_validation.png

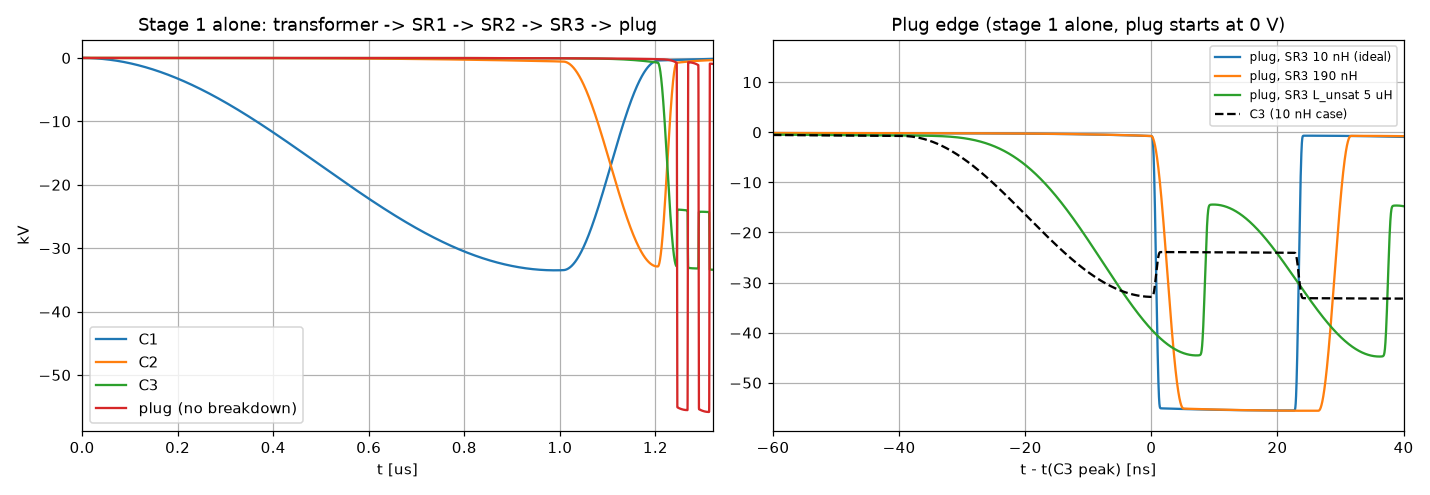
sim/plots/01_stage1_validation.png
