EdgerEquals/plasma-ignition/sim/plots/02_stage2_block_validation.png

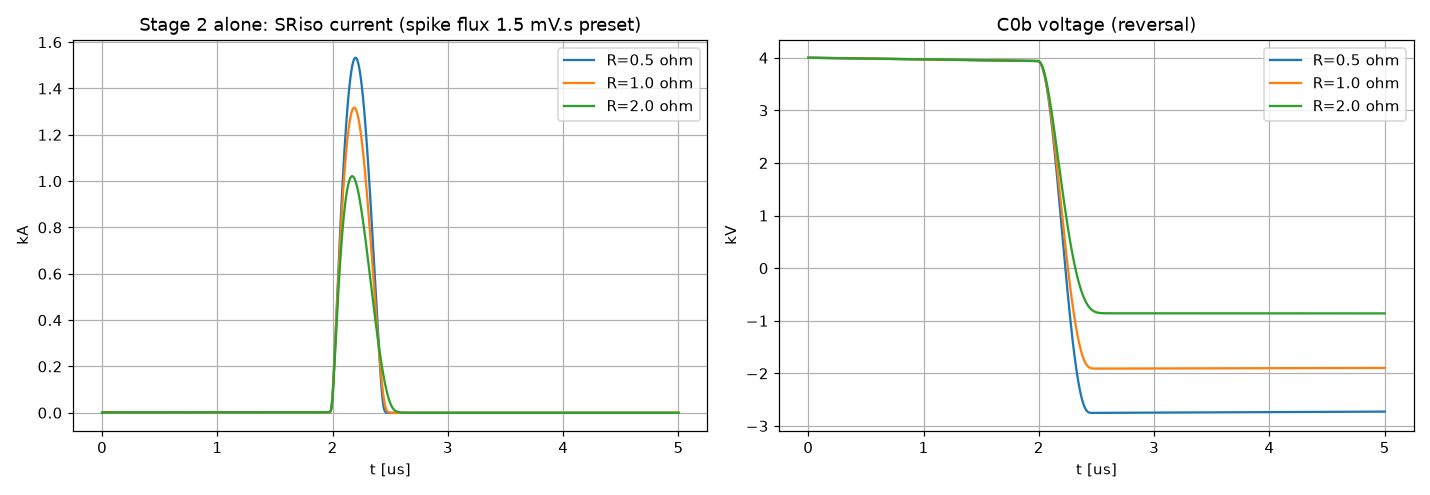
sim/plots/02_stage2_block_validation.png
