EdgerEquals/plasma-ignition/sim/netlists/v2test_lossy1.cir

* Plasma Ignition Rev B  blocks=stage1  model=eddy
.options method=gear reltol=1e-4 abstol=1e-9 vntol=1e-4 itl4=200 maxord=2
C0a a0 0 9.6e-08 IC=1100
D_igbt a0 a1 DSW
.model DSW D(Is=1e-12 N=1 Rs=1m)
L_leak a1 a2 2.10976e-06
L_pri a2 0 0.001
L_sec 0 n1 0.961 IC=0
K_x L_pri L_sec 1
C1 n1 0 1e-10 IC=0
C2 n2 0 1e-10 IC=0
C3 n3 0 1e-10 IC=0
R_bleed n3 0 1e+07
* v2 core SR1: N=100 A=8.5e-05 le=0.2 dB=2 VS=0.017 Hc=2.5 ke=4.5e-05 mui=50000 Lair=8.1e-05
L_SR1_air n2 SR1_m 8.1e-05
G_SR1 0 lam_SR1 SR1_m n1 1
C_SR1 lam_SR1 0 1
R_SR1 lam_SR1 0 1e15
B_SR1 SR1_m n1 I = 0.002*(2.5*tanh((v(SR1_m,n1)/0.0085)/10000) + 4.5e-05*(v(SR1_m,n1)/0.0085) + v(lam_SR1)/0.000534071) + (1/4.05e-06)*((uramp((v(lam_SR1)-0.017)) + 3.4000000000000007e-05*ln(1+exp(-abs((v(lam_SR1)-0.017))/3.4000000000000007e-05))) - (uramp((-v(lam_SR1)-0.00034)) + 3.4000000000000007e-05*ln(1+exp(-abs((-v(lam_SR1)-0.00034))/3.4000000000000007e-05))) + 1.54356e-09)

* v2 core SR2: N=40 A=4.25e-05 le=0.15 dB=2 VS=0.0034 Hc=2.5 ke=4.5e-05 mui=50000 Lair=3.2e-06
L_SR2_air n3 SR2_m 3.2e-06
G_SR2 0 lam_SR2 SR2_m n2 1
C_SR2 lam_SR2 0 1
R_SR2 lam_SR2 0 1e15
B_SR2 SR2_m n2 I = 0.00375*(2.5*tanh((v(SR2_m,n2)/0.0017)/10000) + 4.5e-05*(v(SR2_m,n2)/0.0017) + v(lam_SR2)/0.000106814) + (1/1.6e-07)*((uramp((v(lam_SR2)-0.0034)) + 6.8e-06*ln(1+exp(-abs((v(lam_SR2)-0.0034))/6.8e-06))) - (uramp((-v(lam_SR2)-6.8e-05)) + 6.8e-06*ln(1+exp(-abs((-v(lam_SR2)-6.8e-05))/6.8e-06))) + 3.08713e-10)

* saturable inductor SR3: Ls=1e-08 Lu=0.001 VS=0.00068
G_SR3 0 lam_SR3 x n3 1
C_SR3 lam_SR3 0 1
R_SR3 lam_SR3 0 1e15
B_SR3 x n3 I = v(lam_SR3)/0.001 + 9.9999e+07*((uramp((v(lam_SR3)-0.00068)) + 1.3600000000000001e-06*ln(1+exp(-abs((v(lam_SR3)-0.00068))/1.3600000000000001e-06))) - (uramp((-v(lam_SR3)-1.36e-05)) + 1.3600000000000001e-06*ln(1+exp(-abs((-v(lam_SR3)-1.36e-05))/1.3600000000000001e-06))) + 6.17425e-11)

C_block x P 1e-09 IC=-0
C_plug P 0 1.5e-11 IC=0
C_iso_w P 0 1.5e-12
V_chg chg 0 PWL(0.000000e+00 0)
B_ch P 0 I = v(P)*(v(chg)/1 + 1/1e+09)

.control
set wr_singlescale
set wr_vecnames
option numdgt=9
tran 0.05n 1.450000e-06 0 2.000e-11 uic
wrdata /workspace/prs/sim/out/v2test_lossy1.dat v(n1) v(n2) v(n3) v(x) v(P) v(lam_SR1) v(lam_SR2) v(lam_SR3) v(chg) v(a0) i(L_leak)
quit
.endc
.end
