EdgerEquals/plasma-ignition/(commit log)

2026-10-22 Initial commit: Plasma Ignition Rev B simulation and design review
    [results.csv]
2026-11-07 Add technical handover document for first prototype plasma ignitor module
2026-11-07 Add website update page for Vikas summarizing progression to locked GX120 prototype
